EasySensors/easyPIRmultisensorsBox/pics/EasyPIR-holder.jpg

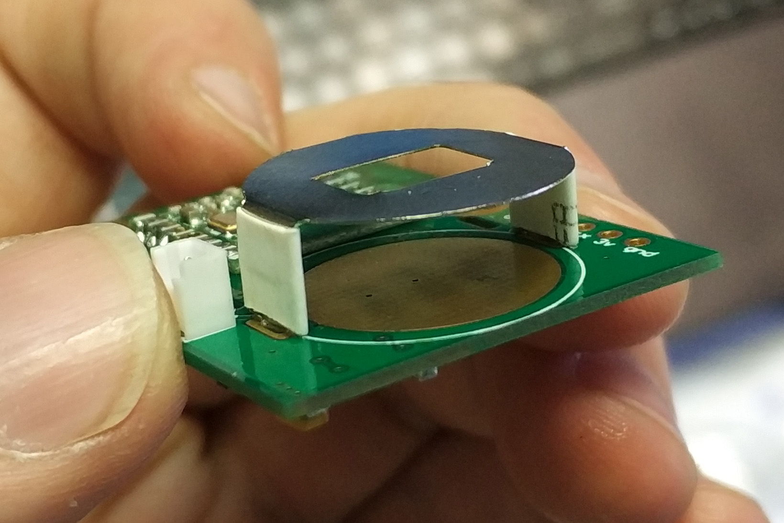
pics/EasyPIR-holder.jpg
