EasySensors/easyPIRmultisensorsBox/pics/EasyPIR-nrf-2.jpg

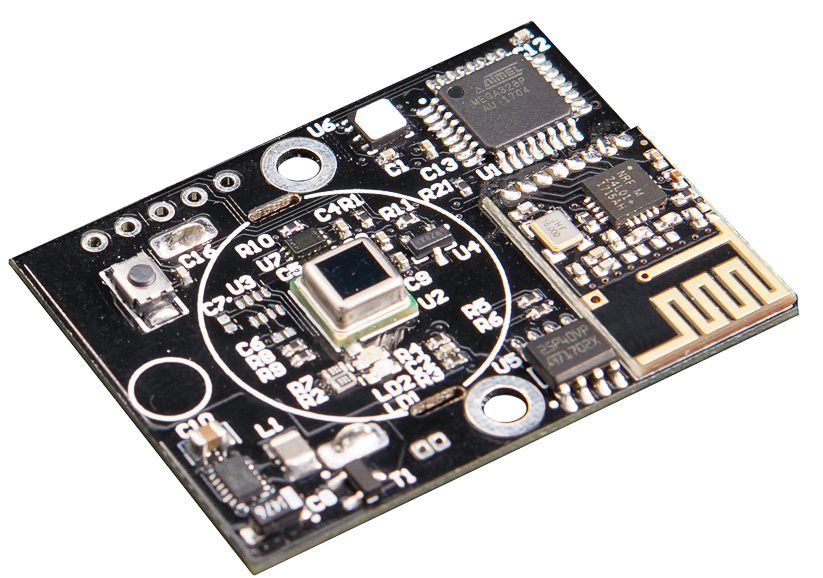
pics/EasyPIR-nrf-2.jpg
