EasySensors/easyPIRmultisensorsBox/pics/EasyPIR-nrf-3.jpg

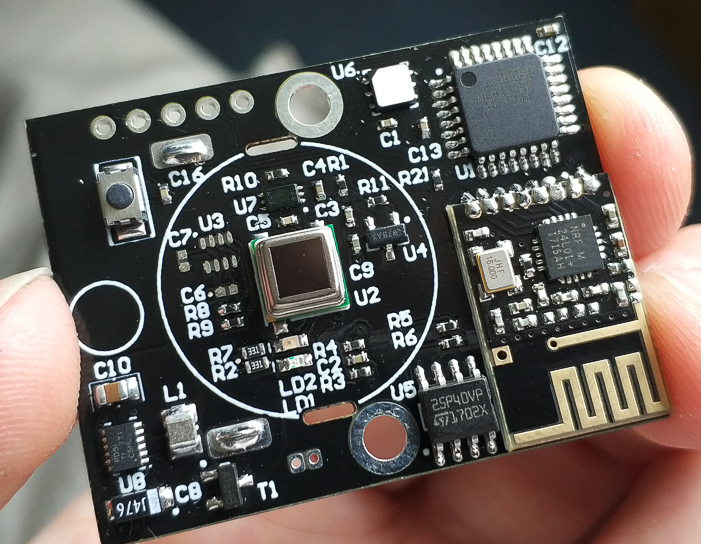
pics/EasyPIR-nrf-3.jpg
