EasySensors/easyPIRmultisensorsBox/pics/pir_without_si7021.jpg

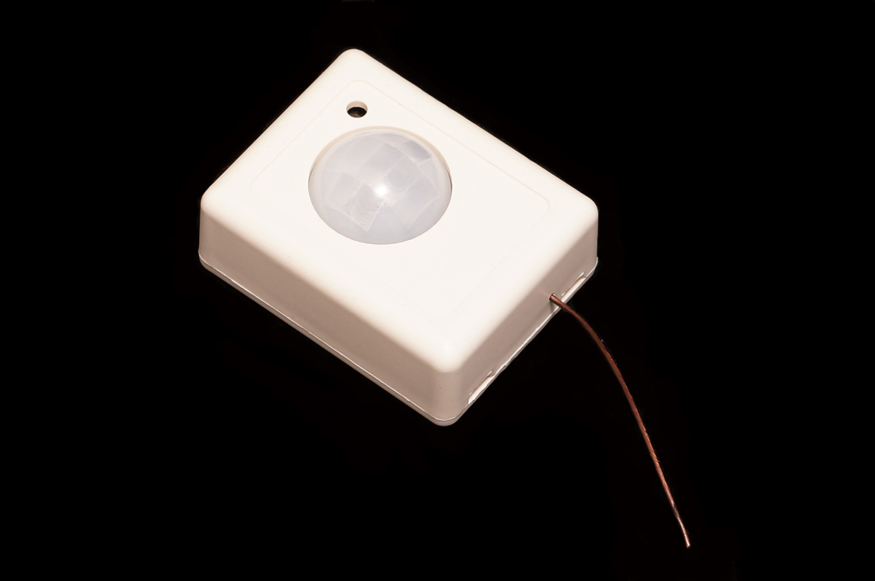
pics/pir_without_si7021.jpg
