EasySensors/easyPIRmultisensorsBox/pdf/pir_31x41.PDF

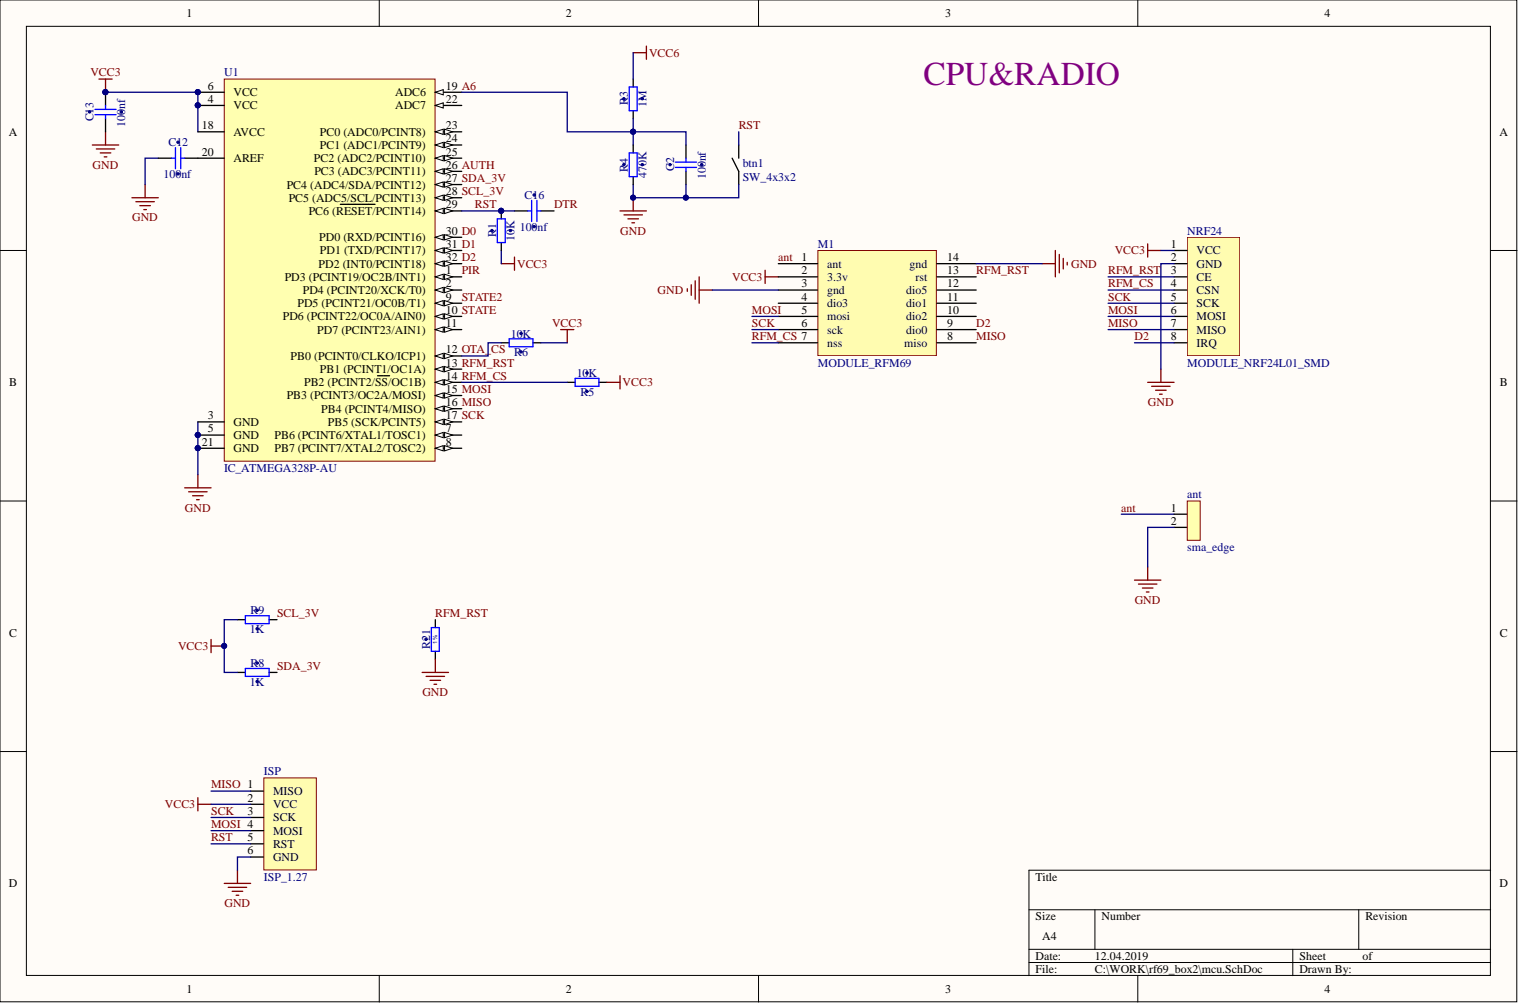
[picture p17: page 1]

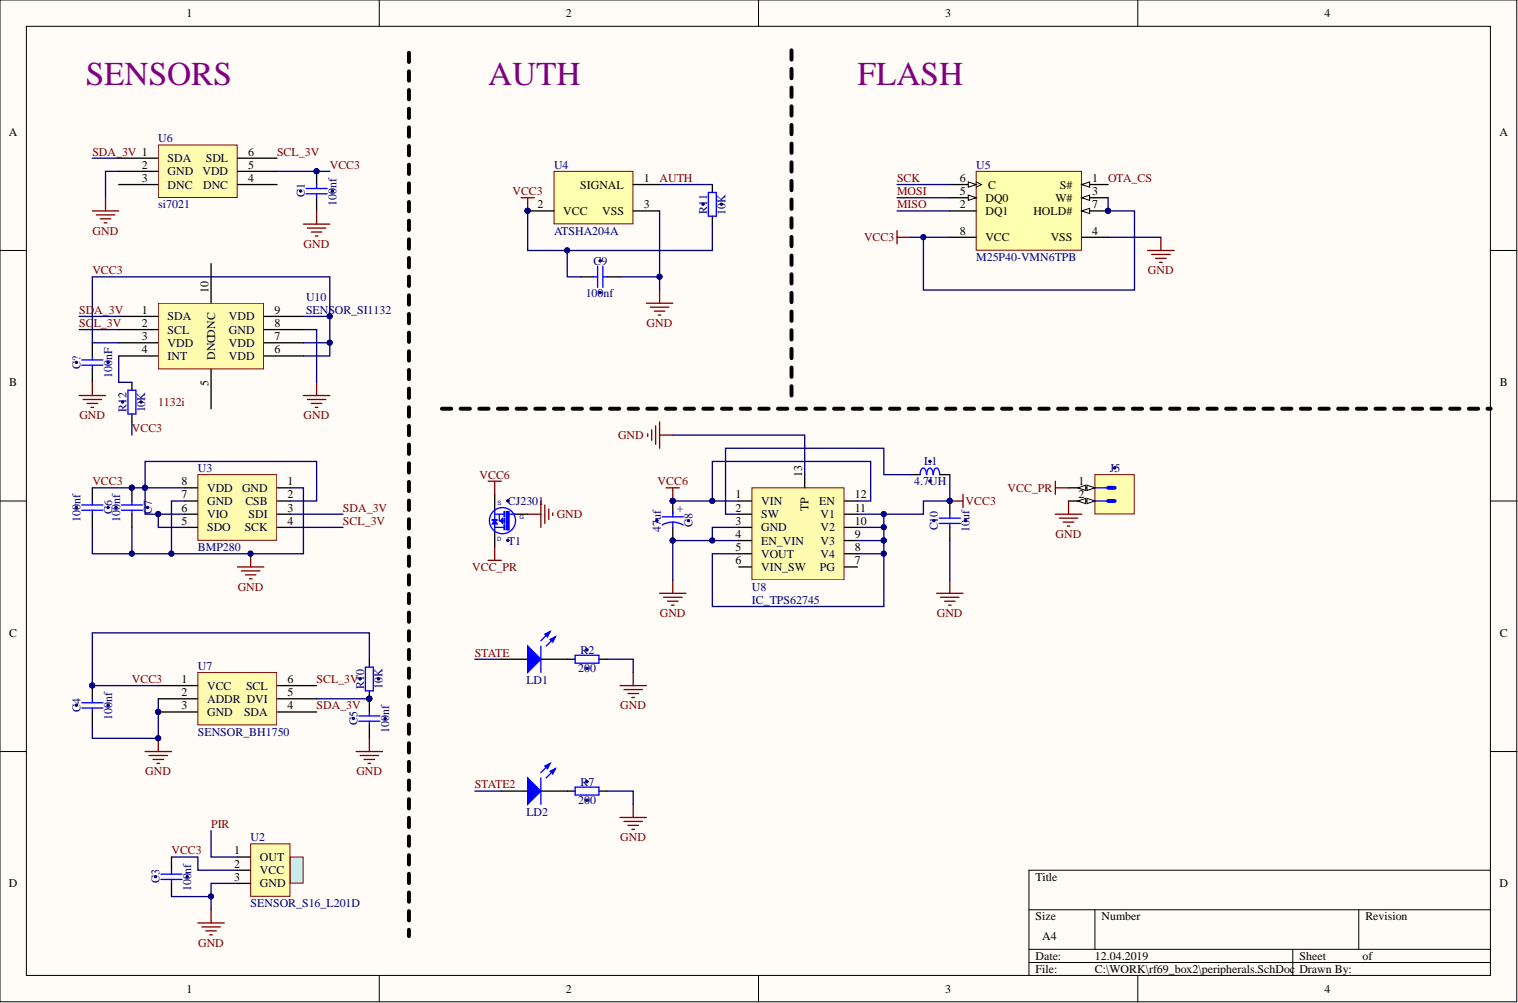
[picture p18: page 2]

VCC 2
GND 3
