EasySensors/easyPIRmultisensorsBox/(threads)

Thread 1 (2018-12-04):

s16 l201d

lutzh86, 2018-12-04:
did u have no problems with the sensor itself?

we tested a lot of them and they start to fail soon with false positives.

yurysvirida, 2018-12-04:
Hi

Do you mean PIR sensor?  No. If PIR I run tests for couple of month before ordering them.  do you use battery power? or AC- DC power supply?

lutzh86, 2018-12-04:
acutally i tried all possible methods.

now just 2* 1.5V AA batteries directly connected to sensor, a capacitor  and just looking output REL on voltmeter.

i got 10 samples almost every is broken

yurysvirida, 2018-12-04:
Same  S16-L201D?   it is really hard to solder. Many have been broken while soldering .  also if I used small square lens and was trying to remove it I usually brake it physically .  it is fragile. maybe you have broken one?

lutzh86, 2018-12-04:
no thats not the point, i am soldering down to 0201 with my eyes :-)

i actually found the problem, they are not pyhsically broken, they just too sensitive. not everyone from the beginning, but they got more and more sensitive

https://www.youtube.com/watch?v=-C7kVfhjnyY

https://www.youtube.com/watch?v=UyjPPvxQZZ8

so i will switch over to L221D

yurysvirida, 2018-12-04:
wow 0201!  :)

Have you bought directly from SENBA?  I checked test sensors log down for a couple of days. Have few with logs. No false positives during nights so far.  4- 6 month old devices.

lutzh86, 2018-12-04:
well i need propably  at least 10k of them. but the "broken" ones are also responsive for shaking in a black box ;o

yurysvirida, 2018-12-05:
okay, but box could be warmer at some places and colder at the others. Since there is no lens it could probably pickup temperature difference? fix it inside and close box so the are not moving against each other. and shake. My tigers up when I moved it around notebook.

Thread 2 (2019-10-26):

Power consumption

maxholgasson, 2019-10-26:
HI,
what's the power consumption with the RFM69CW module? How long will the two small batteries last?

yurysvirida, 2019-10-27:
Hi,

17uA sleep time current drain.   1-2  years life time depends on how often some movement around detected.
