EasySensors/easyPIRmultisensorsBox/(notices)

Notices in the files:
easyPIRmultisensorsBoxWithTempHumSensor.ino:
modify it under the terms of the GNU General Public License
